ravczar/FM-radio-with-Clock/photos.pdf

TEA 5767 chip soldiered on breadboard (raster is 2[mm] instead of 2.54)

PLann main paths, SDA, SCL, VCC 5[V], GND, power supply pins and pcb mounting spots.

More or less ready Board TOP view

Read side of main board.

After mounting.

TOP

Left side

Right side

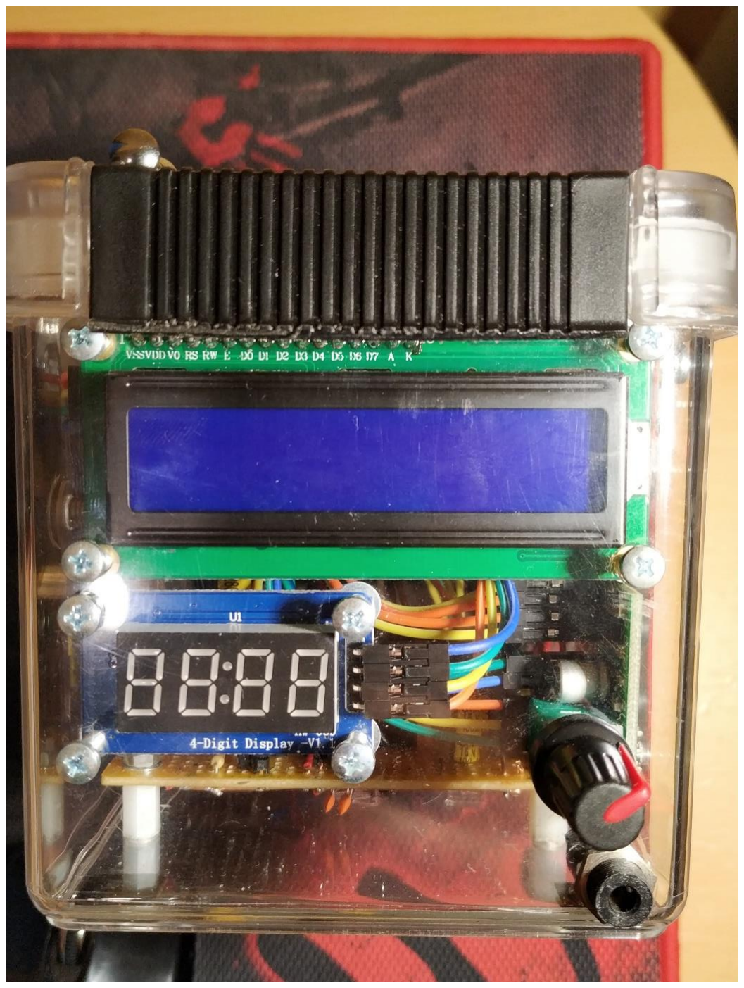
[picture p1: figure]

Front side

Rear side

Bottom side.

Radio ON

Tuner, AMP off
