ravczar/FM-radio-with-Clock/FM RADIO TEA5767 with RTC.pdf

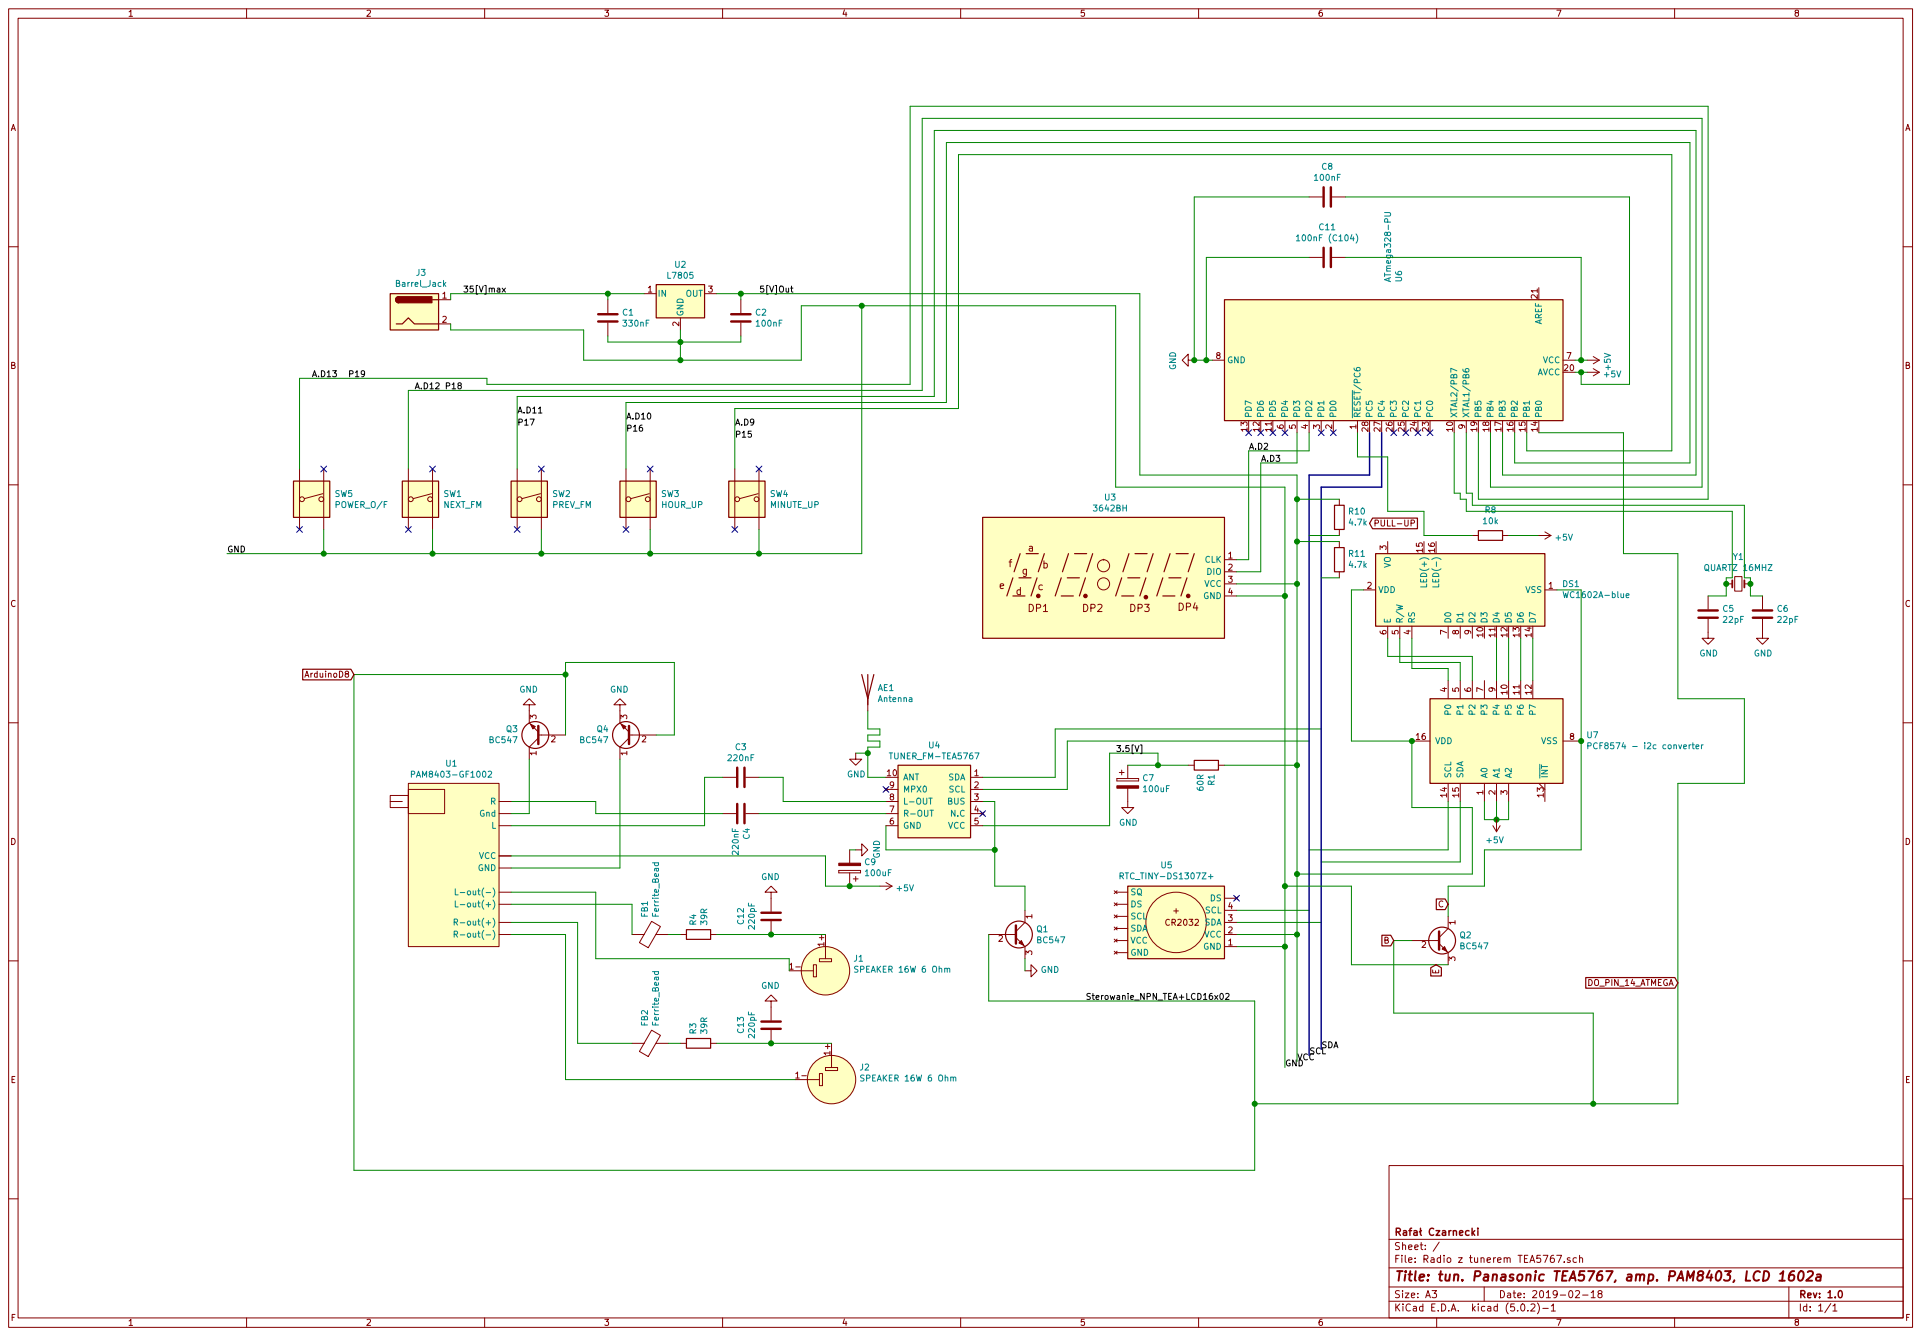
[picture p2: page 1]

File: Radio z tunerem TEA5767.sch Sheet: / Rafa Czarnecki RESET/PC6

1 P5 10 P6 11 P7 12 INT 13 SCL 14 SDA 15 VDD 16 A1

Id: 1/1 Title: tun. Panasonic TEA5767, amp. PAM8403, LCD 1602a
